josaia125/Proyecto-2-Electronica-2/Evidencia visual/montajefinal.jpeg

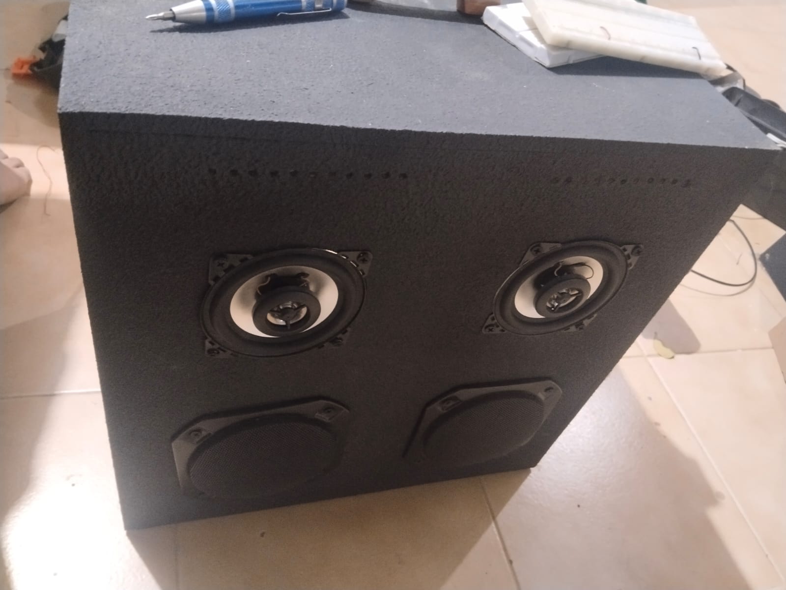
Evidencia visual/montajefinal.jpeg
