josaia125/Proyecto-2-Electronica-2/Evidencia visual/baquela.jpeg

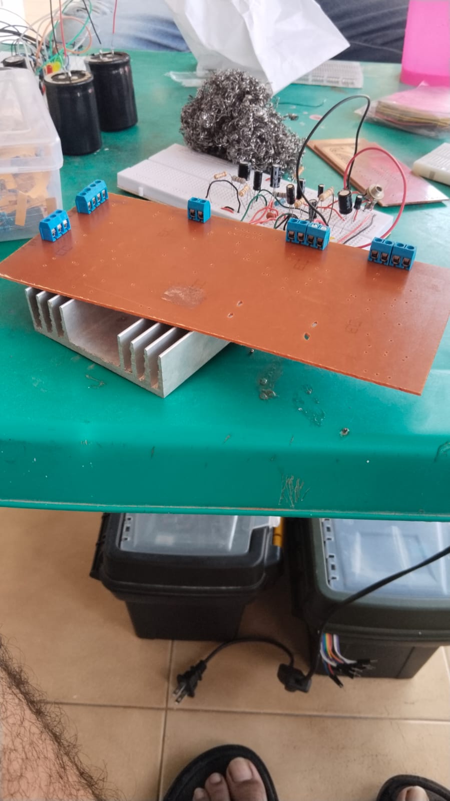
Evidencia visual/baquela.jpeg
