josaia125/Proyecto-2-Electronica-2/Informe-proyecto2.pdf

# Proyecto II: Amplificador Estereo de Alta Fidelidad ´ Basado en TDA2005

Cristian García, Daniel Forero, Juan Lobo, Jesus Bustamante, Jorge De ´ | Avila ´
I. INTRODUCCION´
E

l presente proyecto tiene como finalidad el diseno e im- ˜
plementacion de un amplificador est ´ | ereo de alta fidelidad ´
basado en el circuito integrado TDA2005. Este componente, ampliamente utilizado en aplicaciones de audio automotriz, ofrece una potencia de hasta 20 W y cuenta con protecciones internas que lo convierten en una opcion confiable para el ´ desarrollo de prototipos.
La iniciativa busca integrar distintos elementos de disenõ electronico —como un preamplificador JFET, conectividad ´ Bluetooth, una placa de circuito impreso disenada por el ˜ equipo y una carcasa comercial— con el proposito de obtener ´ un sistema funcional que cumpla con los requisitos tecnicos ´ mínimos y pueda proyectarse hacia aplicaciones reales en el mercado.
Mas all ´ | a de la construcci ´ | on del prototipo, este trabajo repre- ´
senta un ejercicio de aplicacion pr ´ | actica de los conocimientos ´
adquiridos en la formacion acad ´ | emica. Se pretende demostrar ´
como la teor ´ | ía puede transformarse en un producto tangible,
capaz de ofrecer una experiencia sonora de calidad y de responder a las necesidades actuales de consumo tecnologico. ´ Este informe presenta el con texto, los objetivos y los lineamientos de ingeniería que guían el proyecto, así como los entregables esperados y la planificacion necesaria para su ´ desarrollo exitoso.
| | II. OBJETIVOS
A. Objetivo general
Disenar e implementar un amplificador de audio est ˜ | ereo ´
de alta fidelidad basado en el circuito integrado TDA2005, que permita reproducir senales de audio con buena calidad y ˜ cumpla con características funcionales similares a aplicaciones comerciales.
B. Objetivos específicos
- Disenar el circuito del amplificador utilizando el ˜ TDA2005.
- Implementar una etapa de preamplificacion basada en un ´ transistor JFET.
- Integrar un modulo de entrada Bluetooth para la re- ´
cepcion de audio inal ´ | ambrico. ´
- Construir el circuito en una placa PCB garantizando una adecuada distribucion de los componentes. ´
- Implementar una fuente de alimentacion adecuada para ´ el correcto funcionamiento del sistema.
- Evaluar el desempeno del amplificador en t ˜ | erminos de ´
calidad de sonido y funcionamiento.

III. MARCO TEORICO ´

Un amplificador de audio es un dispositivo electronico ´
disenado para incrementar la potencia de una se ˜ | | nal sonora, per- ˜
mitiendo excitar transductores electroacusticos con la energ ´ | ía
necesaria para una reproduccion clara. En sistemas de alta ´
fidelidad (Hi-Fi), la calidad se mide a traves de la Distorsi ´ | on´
Armonica Total (THD) y la Relaci ´ | on Se ´ | nal a Ruido (SNR), ˜
donde valores de SNR superiores a 90 dB garantizan una experiencia libre de ruido perceptible [1].
El nucleo de potencia de este proyecto es el TDA2005, ´ un amplificador Clase B disenado originalmente para audio ˜ automotriz. Este integrado es capaz de entregar hasta 10+10W
en configuracion est ´ | ereo con cargas de ´ | 2Ω, soportando corri-
entes de pico de hasta 3.5A [2]. Una de sus mayores ventajas competitivas es su robustez, ya que incorpora protecciones nativas contra cortocircuitos, sobrecalentamiento y fluctuaciones severas de voltaje (load dump).
Para la etapa de preamplificacion se utilizan transistores de ´
efecto de campo de union (JFET) en configuraci ´ | on de seguidor ´
de fuente (drenaje comun). Esta topolog ´ | ía se caracteriza por
poseer una impedancia de entrada extremadamente alta (Zin ≈ RG) y una impedancia de salida baja, lo que permite acoplar la senal de audio sin cargar la fuente de entrada y minimizando ˜ la distorsion por desajuste de impedancias [3], [4]. ´
En amplificadores de potencia, la gestion del calor es ´ crítica. El diseno de la placa de circuito impreso (PCB) debe ˜ contemplar planos de tierra solidos para reducir EMI y pistas ´ de ancho calculado para soportar la demanda de corriente,
ademas del uso de disipadores t ´ | ermicos para mantener el punto ´
de operacion del silicio dentro de los l ´ | | ímites seguros [7].

IV. RESUMEN
Este documento detalla el diseno, simulaci ˜ | on e imple- ´
mentacion f ´ | ísica de un sistema de amplificacion de audio ´
estereo de alta fidelidad basado en el circuito integrado ´ TDA2005. El proyecto integra una etapa de acondicionamiento
de senal mediante transistores JFET 2N5457 en configuraci ˜ | | on´
de seguidor de fuente, disenada para optimizar la impedancia ˜
de entrada y preservar la integridad de la senal. La metodolog ˜ | ía
incluyo el modelado matem ´ | atico en MATLAB, donde se ´
determino una ganancia te ´ | orica de ´ | 0.88, y la validacion en ´
Proteus, obteniendo una ganancia experimental de 0.96. El sistema incorpora una fuente de alimentacion interna con ´
filtrado robusto de 10, 000µF, conectividad inalambrica v ´ | ía
Bluetooth y una entrada analogica Jack 3.5mm. El prototipo ´ final fue ensamblado en una carcasa comercial utilizando una
PCB de diseno original, cumpliendo con los est ˜ | | andares de ´

robustez, gestion t ´ ermica y calidad sonora exigidos para un ´ producto de nivel comercial.
Palabras clave— Amplificacion de audio, TDA2005, JFET, ´ Impedancia, Bluetooth, PCB, Fidelidad.
V. DESARROLLO

A continuacion, se presenta el desarrollo del proyecto, ´ donde se explica paso a paso la construccion del amplificador ´ de audio, los calculos y analisis hecho. ´

A. Calculos del preamplificador JFET
| | En esta seccion se presentan los c ´ | alculos realizados para el ´
diseno del preamplificador. Para esta etapa hicimos uso de el ˜ JFET 2N5457, se utilizo el siguiente script de MATLAB: ´
1 | %% =============================
2 | % | TRANSCONDUCTANCIA gm
3 | % ==============================
4 | gmo = (2 * IDSS) / abs(VP);
5 | gm | = gmo * (1 - VGSQ/VP);
6 | fprintf(’=== TRANSCONDUCTANCIA ===\n’);
7 | fprintf(’gmo = %.4f mS\n’, gmo*1e3);
8 | fprintf(’gm | = %.4f mS\n\n’, gm*1e3);

9
10 | %% =============================
11 | % | 2) RESISTENCIA RS
12 | % ==============================
13 | % En Drenaje Comun no existe RD -> RD = 0
14 | RS = (VDD - VDS) / IDQ;
15 | fprintf(’=== RESISTENCIAS ===\n’);
16 | fprintf(’RS = %.0f Omega\n\n’, RS);

17
18 | %% =============================
19 | % | CAPACITORES DE ACOPLE (f = 20 Hz)
20 | % ==============================
21 | f | = 20; | % Frecuencia minima [Hz]
22 | Rent = 221e3; | % Resistencia de entrada = Rg
23 | RL | = 70e3; | % Resistencia de carga = Rent
| | TDA2005
24 | C_entrada = 1 / (2*pi*f*Rent);
25 | C_salida | = 1 / (2*pi*f*RL);
26 | fprintf(’=== CAPACITORES DE ACOPLE ===\n’);
27 | fprintf(’C_entrada >= %.2f nF -> C elegido = 2.2 uF\
n’, C_entrada*1e9);
28 | fprintf(’C_salida | >= %.4f uF -> C elegido = 2.2 uF\
n\n’, C_salida*1e6);

29
30 | %% =============================
31 | % | ANALISIS AC
32 | % ==============================
33 | Rg = Rent;
34 | RS_prima = (RS * RL) / (RS + RL); % RS // RL
35 | fprintf(’=== ANALISIS AC ===\n’);
36 | fprintf(’RS’’ = RS // RL = %.2f Omega\n’, RS_prima);

37
38 | % Ganancia de voltaje
39 | Av = (gm * RS_prima) / (1 + gm * RS_prima);
40 | fprintf(’Av | = %.4f\n’, Av);

41
42 | % Impedancias
43 | Zin | = Rg;
44 | Zout = RS_prima;
45 | fprintf(’Zin | = %.2f MOhm\n’, Zin/1e6);
46 | fprintf(’Zout = %.2f Omega\n\n’, Zout);

47
48 | %% =============================
49 | % | GANANCIA DE CORRIENTE
50 | % ==============================
51 | Ai = Av * (Rg / RL);
52 | fprintf(’=== GANANCIA DE CORRIENTE ===\n’);
53 | fprintf(’Ai = %.4f\n\n’, Ai);

Listing 1. Script de diseno en MATLAB ˜

Los resultados obtenidos en la consola tras la ejecucion son ´ los siguientes:

=== PUNTO Q ===
IDQ = 1.50 mA
VGSQ = -0.90 V
VDS = 9.00 V

=== TRANSCONDUCTANCIA ===
gmo = 2.0000 mS
gm = 1.4000 mS

=== RESISTENCIAS ===
RS = 6000 Omega

=== CAPACITORES DE ACOPLE ===
C_entrada >= 36.01 nF | -> C elegido = 2.2 uF
C_salida | >= 0.1137 uF -> C elegido = 2.2 uF

=== ANALISIS AC ===
RS’ = RS // RL = 5526.32 Omega
Av | = 0.8855
Zin | = 0.22 MOhm
Zout = 5526.32 Omega

=== GANANCIA DE CORRIENTE === Ai = 2.7958

========== RESUMEN ==========
IDQ | = 1.50 | mA
VGSQ | = -0.90 | V
VDS | = 9.00 | V
gm | = 1.4000 mS
RS | = 6000 | Omega
Av | = 0.8855
Ai | = 2.7958
Zin | = 0.2 | MOhm
Zout | = 5526.32 | Omega
C_ent = 2.2 uF
C_sal = 2.2 uF
==============================

Listing 2. Salida de consola de MATLAB actualizada

B. Acondicionamiento (Preamplificador JFET)

Siguiendo la arquitectura del sistema, la etapa de acondicionamiento se basa en un preamplificador con transistores JFET J111 en configuracion de seguidor de fuente. Esta etapa ´
es crucial para procesar la senal proveniente del m ˜ | odulo ´
Bluetooth antes de su ingreso a la etapa de potencia. Para
validar el diseno, se realiz ˜ | o una simulaci ´ | on en Proteus con ´
una senal de entrada de ˜ | 100mV a 5kHz.
1) Analisis de Corrientes y Punto Q: ´ | | Como se observa
en la simulacion de la Figura 1, el dispositivo presenta un ´ comportamiento ideal para el acoplamiento de senales. La ˜ corriente de compuerta (Ig) es de 0mA debido al aislamiento
electrico del FET, mientras que las corrientes de drenaje ( ´ | Id)
y fuente (Is) se mantienen equilibradas en 1.74mA.

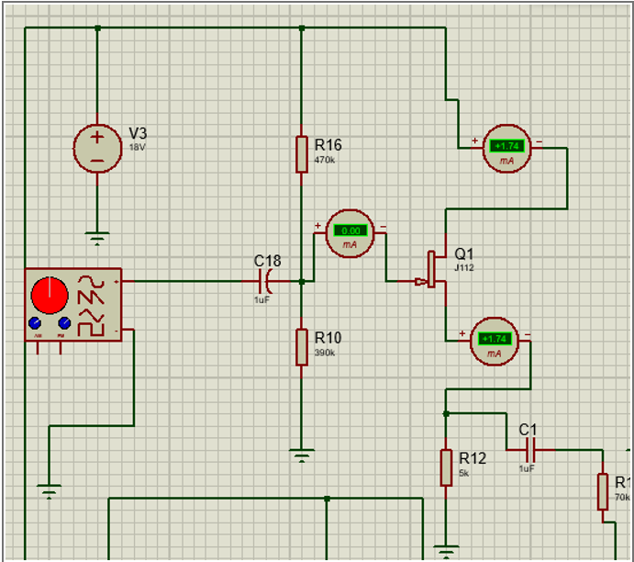
[picture p3: figure]

Fig. 1. Simulacion de corrientes en el preamplificador (Id = Is = 1.74 ´ | mA).
2) Analisis de Voltajes en DC: ´ | En la Figura 2 se detallan
los niveles de tension obtenidos. Los resultados confirman que ´ el transistor opera en su region activa, permitiendo el flujo de ´
senal sin distorsi ˜ | on hacia el TDA2005. ´

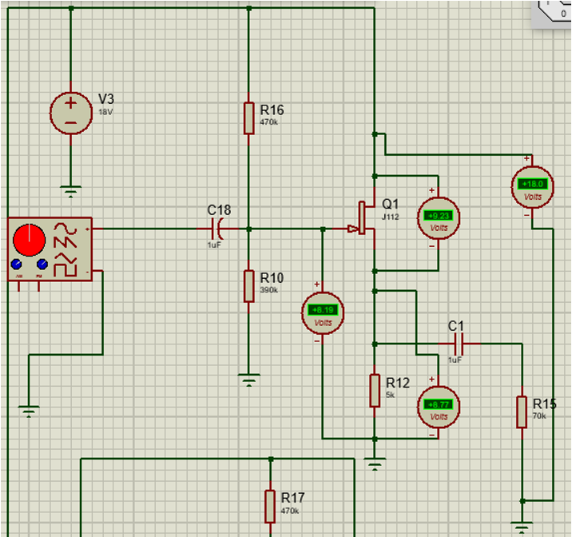
[picture p4: figure]

Fig. 2. Distribucion de voltajes en los nodos del JFET 2N5457. ´

3) Validacion de la Ganancia de Voltaje ( ´ | Av): Para ver-
ificar la eficiencia de la etapa de acondicionamiento, se
midieron las senales de entrada ( ˜ | Vi) y salida (Vo) mediante
un osciloscopio digital en el entorno de simulacion. Los ´ parametros configurados en los generadores fueron una am- ´ plitud de 100mV a una frecuencia de 5kHz.

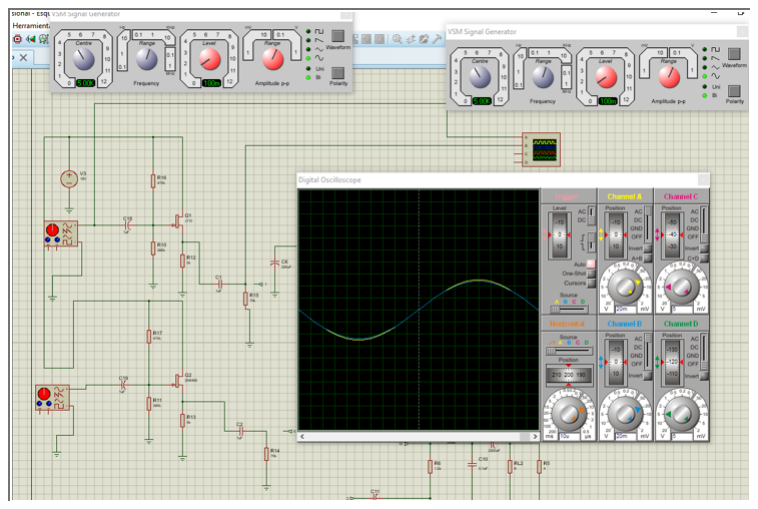
[picture p5: figure]

Fig. 3. Medicion de se ´ | nales de entrada y salida en el osciloscopio digital. ˜

Basado en las capturas del osciloscopio, el analisis de las ´ divisiones por voltajes es el siguiente:
- Voltaje de Entrada (Vi): 5 divisiones × 20 mV/div = 0.1V .
- Voltaje de Salida (Vo): 4.8 divisiones × 20 mV/div = 0.096V .
A partir de estos datos, se calculo la ganancia de voltaje ´ experimental (Av exp):

Av =

Vo
Vi

=

0.096
0.1
| | | = 0.96 | | (1)
Analisis de resultados: ´ | La ganancia obtenida experimen-
talmente (0.96) presenta una alta correlacion con el valor ´
teorico calculado en MATLAB ( ´ | 0.8855), validando que el
preamplificador JFET en configuracion de seguidor de fuente ´ cumple satisfactoriamente con su funcion de acoplamiento ´
sin perdidas significativas de se ´ | | nal. Los valores de tensi ˜ | | | on´
registrados respecto a tierra son:
- Voltaje de Compuerta (Vg): 8.19V .
- Voltaje de Drenaje (Vd): 18V .
- Voltaje de Fuente (Vs): 8.77V .
- Tension Drenaje-Fuente ( ´ | Vds): 9.23V .
4) Observaciones del Comportamiento: Se determino que, ´ mientras las corrientes de drenaje y fuente mantienen la misma magnitud, los voltajes en dichos terminales difieren significativamente (18V frente a 8.77V ). Esta caída de tension´ es necesaria para establecer el punto de polarizacion requerido, ´ garantizando que la senal de audio se mantenga dentro de los ˜ margenes de linealidad del componente. ´
C. Esquema | del | Preamplificador | (Etapa | de | Acondi-
cionamiento)

El esquema del preamplificador, detallado en la Figura 4,
constituye la implementacion f ´ | ísica de la etapa de acondi-
cionamiento estereo. El dise ´ | no se basa en dos transistores ˜
de efecto de campo (U1 y U2) en configuracion de seguidor ´
de fuente, permitiendo una adaptacion de impedancias ´ | optima ´
entre la entrada inalambrica y la etapa de potencia. ´

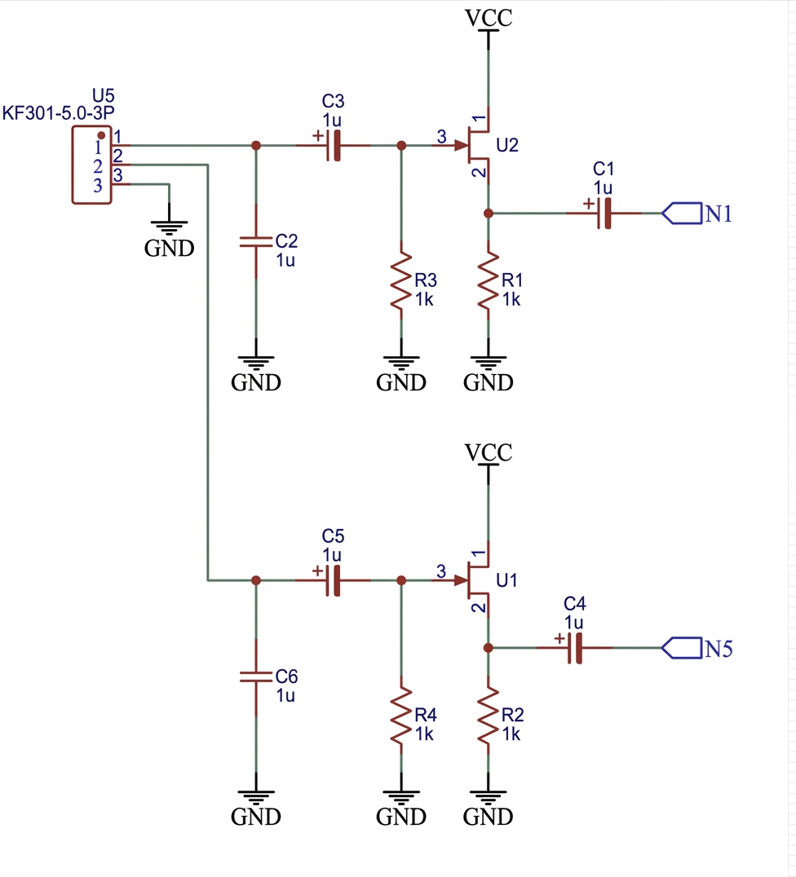
[picture p6: figure]

Fig. 4. Diagrama esquematico de la etapa de preamplificaci ´ | on est ´ | ereo. ´
1) Descripcion de Componentes y Funcionalidad: ´ | El cir-
cuito utiliza una arquitectura simetrica para procesar am- ´ bos canales de audio, empleando los siguientes componentes críticos:
- Terminal de Entrada (U5): El conector KF301 permite
la recepcion de las se ´ | nales izquierda y derecha junto con ˜
la referencia de tierra comun del sistema. ´
- Acoplamiento de Entrada (C3, C5): Capacitores de 1µF encargados de bloquear la componente de corriente continua (DC), permitiendo unicamente el paso de la ´ senal de audio variable. ˜
- Filtros de Desacoplo (C2, C6): Condensadores dispuestos en paralelo a la entrada para estabilizar la senal ˜ y filtrar posibles ruidos de alta frecuencia.
- Polarizacion de Compuerta ( ´ | R3, R4): Resistencias de
1kΩ que referencian la compuerta a tierra, definiendo la impedancia de entrada y el punto de trabajo de los transistores.
- Resistencias de Fuente (R1, R2): Componentes de 1kΩ que determinan la corriente de drenaje en reposo y establecen la baja impedancia de salida necesaria para excitar el TDA2005.
- Acoplamiento de Salida (C1, C4): Capacitores de 1µF que entregan la senal acondicionada a los nodos de salida ˜ (N1, N5) para su posterior amplificacion de potencia. ´
Esta configuracion garantiza que la se ´ | nal de audio conserve ˜
su integridad lineal, proporcionando la ganancia de corriente necesaria para manejar la etapa de potencia sin degradar la calidad sonora.
D. Etapa de Potencia

La etapa de potencia constituye el nucleo del sistema de ´
amplificacion, encargada de entregar la energ ´ | ía necesaria a
los altavoces con la fidelidad requerida. Para este proyecto, se
implemento el circuito integrado ´ | TDA2005, un amplificador
de potencia de audio de clase B disenado espec ˜ | íficamente para
aplicaciones estereo en entornos automotrices y dispositivos ´ portatiles. ´

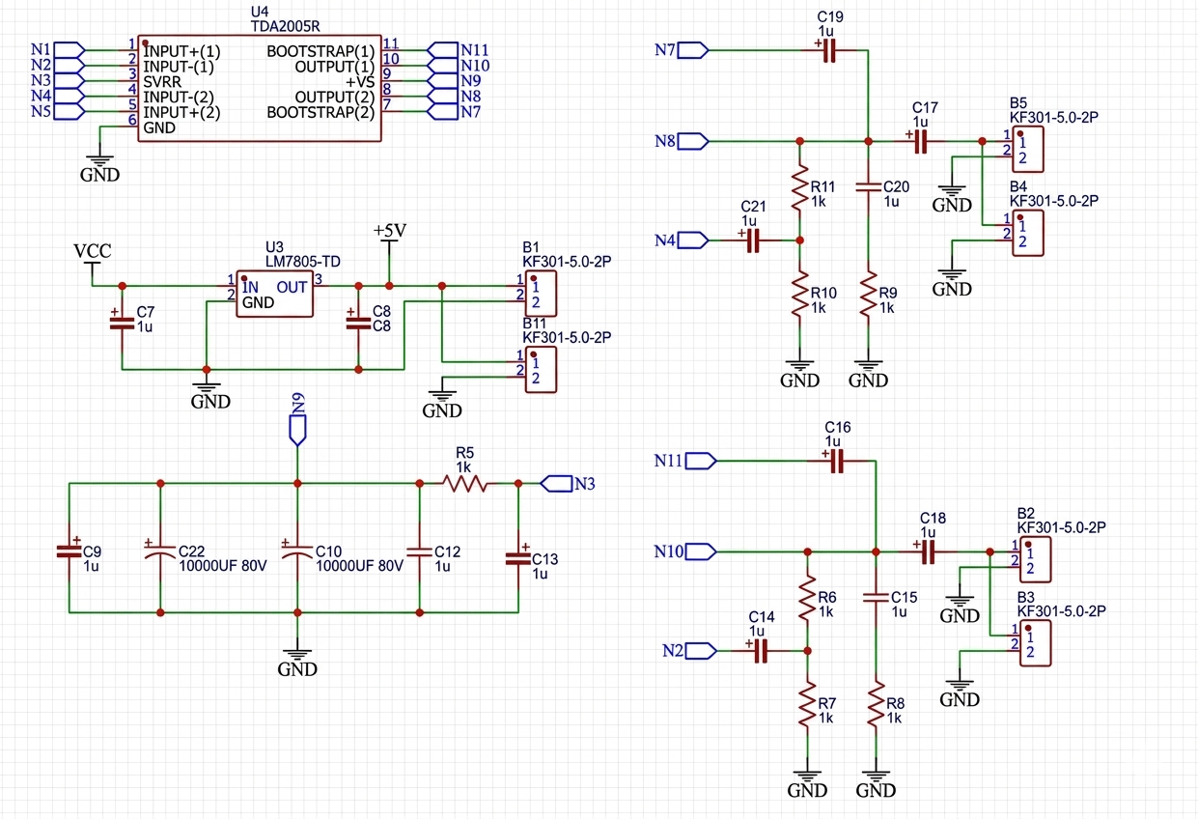
[picture p7: figure]

Fig. 5. Diagrama esquematico de la etapa de potencia y perif ´ | ericos basado ´
en el TDA2005
1) Descripcion del Dise ´ | no y Componentes: ˜ | El esquema
tecnico de la Figura 5 presenta una implementaci ´ | on est ´ | ereo ´
que integra tanto el bloque de amplificacion como los sis- ´ temas de soporte y proteccion. Los elementos principales se ´ describen a continuacion: ´
- Circuito Integrado TDA2005 (U4): El componente central gestiona las entradas de senal ( ˜ N1 a N5) y proporciona las salidas de potencia (N7 a N11) protegidas contra sobrecargas termicas y cortocircuitos. ´
- Red de Estabilizacion de Salida (Filtro Zobel): ´ | Se ob-
serva la integracion de redes compuestas por resistencias ´ (como R9, R10) y capacitores (C20, C15). Estas redes son fundamentales para garantizar la estabilidad del amplificador, evitando oscilaciones parasitas de alta frecuencia ´ cuando se conectan cargas inductivas (altavoces).
- Filtrado de Fuente de Alimentacion: ´ El diseno incluye ˜ una etapa de filtrado robusta con capacitores electrolíticos de gran capacidad (C22, C10) de 10, 000µF. Estos actuan ´ como reservorios de energía para manejar los picos de corriente durante la reproduccion de bajas frecuencias y ´ minimizan el rizado de la fuente.
- Regulacion Auxiliar (U3): ´ | Se integra un regulador de
voltaje LM7805 para proporcionar una salida estable de
+5V , destinada a alimentar perifericos como el m ´ | odulo ´
de entrada Bluetooth, asegurando que el ruido de la etapa de potencia no afecte a la electronica de control. ´
- Acoplamiento y Proteccion: ´ Los capacitores de acoplamiento distribuidos en el circuito (como C19, C16) aseguran que la senal de audio se transfiera eficientemente ˜

entre etapas mientras se bloquea cualquier componente de corriente continua que pudiera danar los transductores. ˜

2) Consideraciones de Implementacion: ´ Aunque el sistema no requiere calculos de ganancia externos debido a la ar- ´
quitectura interna del TDA2005, la disposicion f ´ | ísica de los
componentes y el uso de terminales de conexion KF301 ( ´ | B1
a B5) se seleccionaron para facilitar el montaje en la placa PCB y garantizar conexiones de baja resistencia, minimizando las perdidas de potencia y el calentamiento excesivo durante ´ el funcionamiento a maximo volumen. ´

VI. IMPLEMENTACION´ FÍSICA Y MONTAJE

En esta seccion se detalla la transici ´ | on del dise ´ | no te ˜ | orico ´
hacia el prototipo físico, integrando la manufactura de la PCB, la gestion de potencia interna y el ensamblaje final en el chasis. ´
A. Sistema de Alimentacion Interna ´

Para cumplir con el requisito de autonomía del sistema,
se adquirio una fuente de alimentaci ´ | on interna dedicada 6. ´
Esta decision t ´ | ecnica elimina la dependencia de adaptadores ´
externos y garantiza una entrega de corriente constante para los picos de potencia del TDA2005.

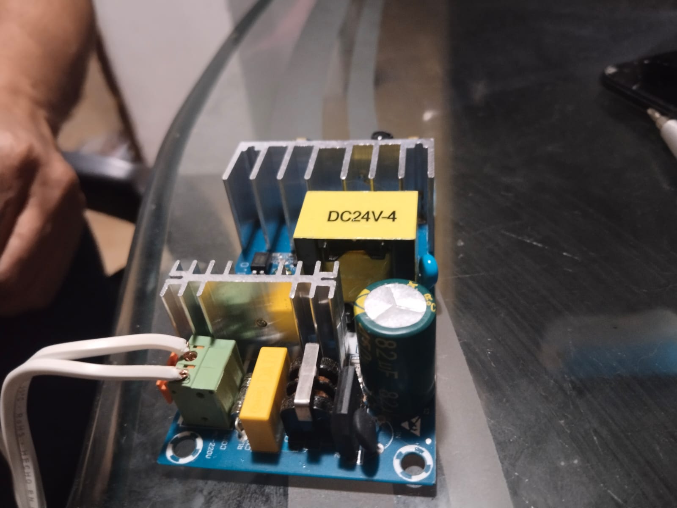
[picture p8: figure]

Fig. 6. Fuente de voltaje conmutada 24V 4-6A

B. Interfaz de Entrada Dual (Bluetooth y Jack 3.5mm)
El diseno inicialmente permit ˜ | ía como versatilidad una in-
terfaz por modulo bluetooth, pero al observar problemas de
ruido, se establecio dos formas de entrada de se ´ | nal: ˜
- Modulo Bluetooth: ´ | Integrado internamente y acoplado a
la etapa JFET. Permite la reproduccion inal ´ | ambrica con ´
un alcance de hasta 10 metros.
- Entrada Auxiliar: Un conector Jack de 3.5mm permite
la conexion de fuentes anal ´ | ogicas. ´
C. Diseno y Manufactura de la PCB ˜
Siguiendo los criterios de diseno original, se desarroll ˜ | o un ´
layout optimizado para audio de potencia.

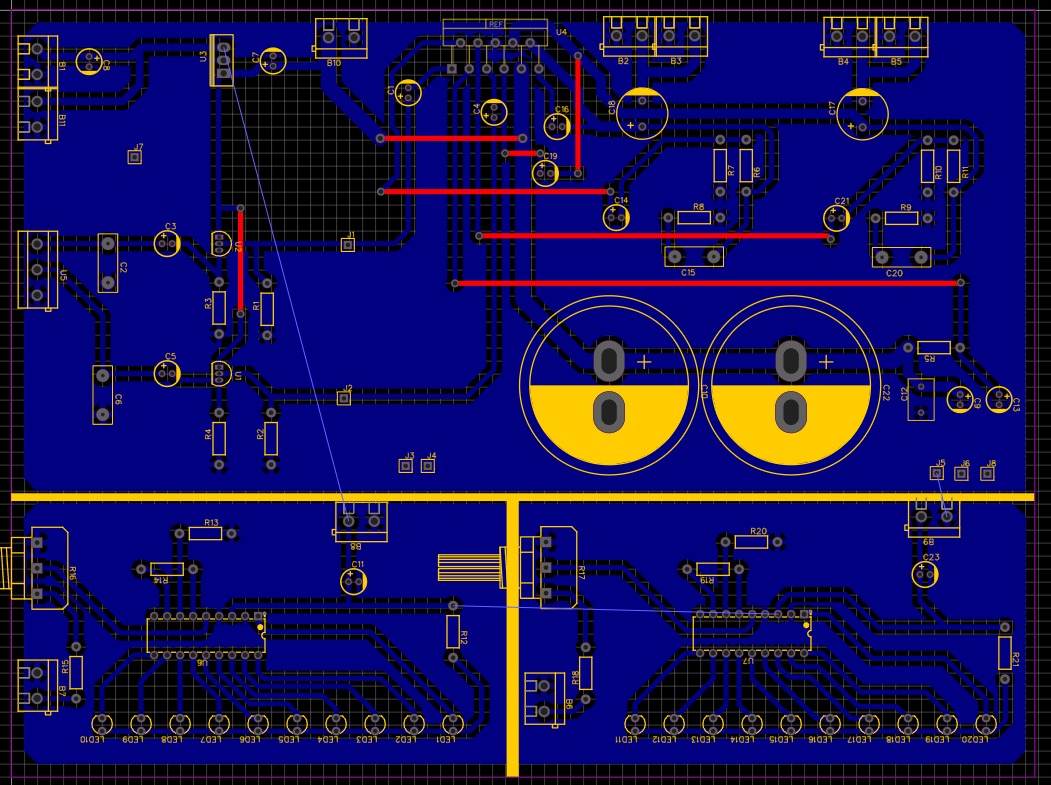
[picture p9: figure]

Fig. 7. Layout original de la PCB

Estrategias de diseno aplicadas: ˜
Rutas de Alta Corriente: Las pistas que conectan la fuente con el TDA2005 y las salidas de los altavoces se disenaron ˜ con un ancho superior (mínimo 50 mils) para minimizar la resistencia ohmica. ´
Integridad de Senal: ˜ Los componentes del preamplificador JFET se agruparon en una zona aislada de las líneas de AC
para reducir la induccion electromagn ´ | etica. ´
D. Prototipado en Protoboard y Pruebas Iniciales
Antes de proceder con el diseno permanente, se realiz ˜ | o un ´
montaje en protoboard para validar la interaccion entre las ´ etapas de acondicionamiento y potencia.
- Validacion de Etapas: ´ | Se comprobo que el preamplifi- ´
cador JFET no introdujera ruido termico excesivo al ser ´ conectado a la entrada del TDA2005.
- Gestion de la Fuente Interna: ´ | Se probo el circuito de ´
rectificacion y filtrado (puente de diodos y capacitores ´ de 10, 000µF) para asegurar que el voltaje DC fuera estable bajo carga y que el regulador LM7805 entregara
los 5V necesarios para el modulo Bluetooth sin ca ´ | ídas
de tension. ´
- Ajustes de Ganancia: Se verifico auditivamente que la ´ ganancia de la etapa de acondicionamiento fuera suficiente para excitar el amplificador de potencia utilizando
tanto el modulo inal ´ | ambrico como la entrada Jack 3.5mm. ´

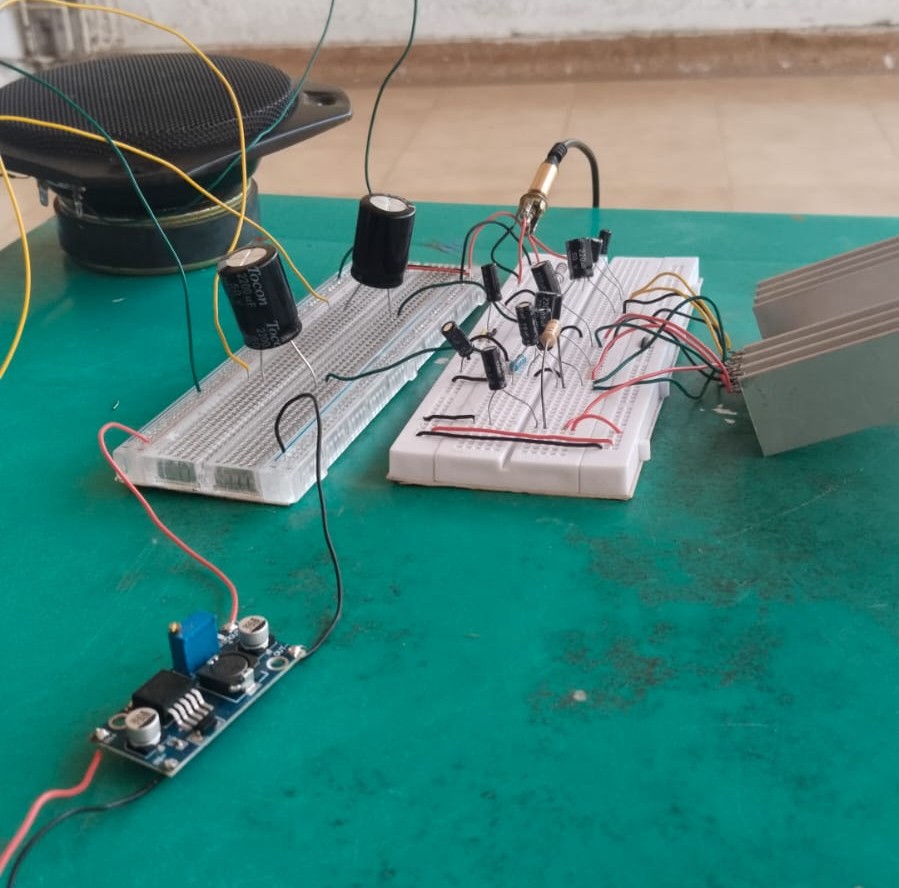
[picture p10: figure]

Fig. 8. Circuito total en Protoboard

E. Montaje en PCB
Siguiendo los requisitos de ingeniería, se ensamblo en la ´ placa de circuito impreso (PCB) para minimizar el ruido y optimizar el espacio interno de la carcasa.

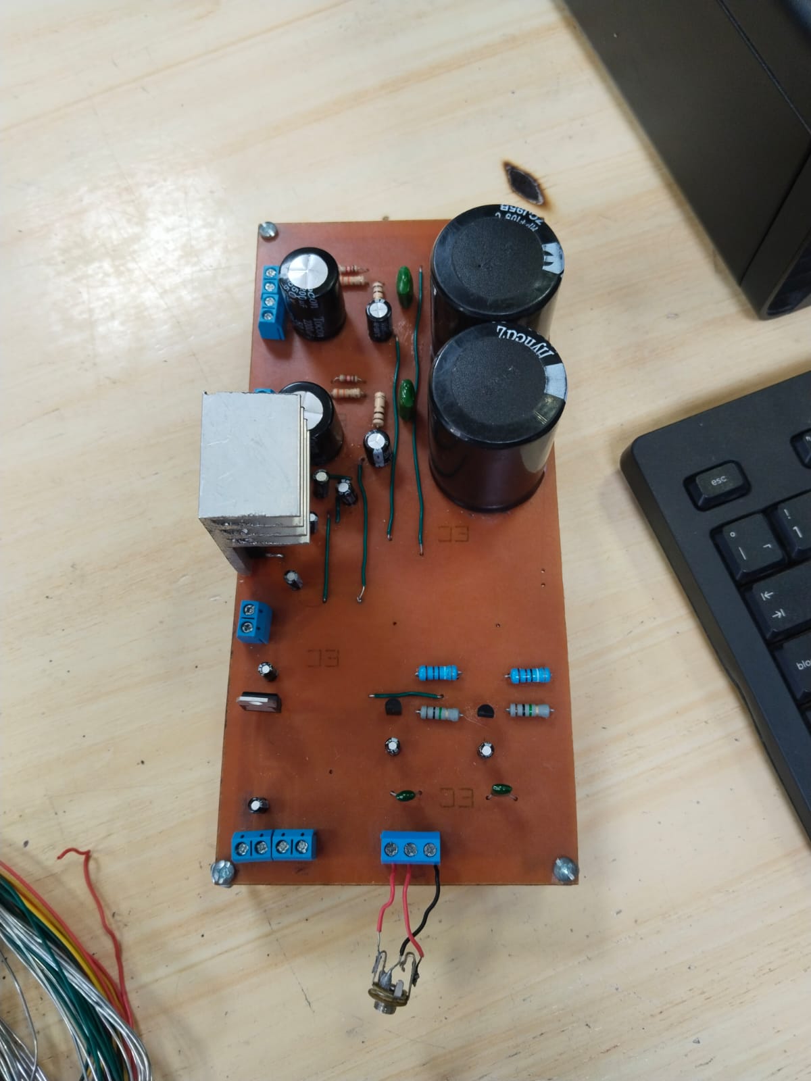
[picture p11: figure]

Fig. 9. Montaje en placa PCB

Detalles del ensamblaje:
- Gestion T ´ | ermica: ´ | El TDA2005 fue montado sobre un
disipador de aluminio acoplado mecanicamente al chasis ´ para maximizar el area de transferencia de calor. ´
- Acabado de Usuario: Se instalaron potenciometros ro- ´ tativos para el control de volumen y bornes KF301 para
una conexion segura de los altavoces, logrando la est ´ | etica ´
de un producto comercial final.
F. Armado Final en Caja Comercial
La etapa final consistio en el mecanizado e integraci ´ | on´
de todos los modulos dentro de un chasis comercial de ´ dimensiones: Alto: 42cm, Ancho: 28cm, Frente: 42cm y así ofrecer un producto terminado y funcional.


Fig. 10. Vista del amplificador ensamblado y listo para el usuario final.

G. Roles y Responsabilidades
Para la ejecucion exitosa del proyecto, se definieron roles es- ´
pecíficos segun las fortalezas t ´ | | ecnicas de cada integrante, ase- ´
gurando una distribucion equitativa del trabajo y el cumplim- ´ iento de los hitos tecnicos: ´
- Cristian García: Responsable de la gestion de la doc- ´
umentacion t ´ | ecnica, apoyo en la redacci ´ | on del informe ´
final y supervisor del cumplimiento de normas IEEE.
- Daniel Forero: Encargado de los calculos matem ´ | aticos ´
y fundamentacion te ´ | orica, dise ´ | no de la etapa de potencia ˜
y supervision de la implementaci ´ | on f ´ | ísica.
- Juan Lobo: Responsable del diseno y mecanizado de la ˜ carcasa comercial, ademas del ensamblaje y soldaje de ´ componentes electronicos. ´
- Jesus Bustamante: ´ | | Especialista en simulacion, encar- ´
gado de validar el comportamiento del sistema en Proteus y verificar los puntos de operacion (Punto Q). ´
- Jorge De Avila: ´ | Co-responsable de la documentacion´
tecnica y c ´ | alculos matem ´ | aticos en MATLAB y l ´ | íder en
la creacion de la presentaci ´ | on final para la sustentaci ´ | on´
academica. ´
| | VII. CONCLUSIONES
- Se disenõ e implement ´ | o con ´ | exito un sistema de amplifi- ´
cacion est ´ | ereo de alta fidelidad, integrando una etapa de ´
acondicionamiento JFET y una etapa de potencia con el TDA2005. El prototipo final demostro estabilidad opera- ´ tiva y una calidad sonora alineada con las expectativas de un sistema de audio comercial, cumpliendo así el objetivo general del proyecto.
- La etapa de preamplificacion mediante transistores JFET ´
J112 resulto fundamental para la adaptaci ´ | on de impedan- ´
cias. La validacion experimental arroj ´ | o una ganancia de ´
voltaje de 0.96, valor que guarda una estrecha correlacion´

con el diseno te ˜ | orico y asegura que la se ´ | nal proveniente ˜
del modulo Bluetooth o la entrada Jack sea procesada sin ´
degradacion ni p ´ | erdida de fidelidad. ´
- La implementacion de una fuente de alimentaci ´ | on in- ´
terna dedicada con filtrado de 10, 000µF garantizo la ´ autonomía del sistema y la estabilidad frente a picos
de corriente. Esta solucion t ´ | ecnica permiti ´ | o minimizar ´
el ruido de rizado de la red electrica, asegurando una ´
relacion se ´ | nal-ruido ˜ | optima para aplicaciones de alta ´
fidelidad.
- El diseno y fabricaci ˜ | on de la placa de circuito im- ´
preso (PCB) original permitio una distribuci ´ | on es- ´
trategica de componentes, reduciendo interferencias elec- ´ tromagneticas y facilitando el manejo de corrientes de ´ hasta 3.5A. El montaje final en un chasis comercial mecanizado transformo el circuito en un producto fun- ´ cional y ergonomico para el usuario final. ´
- La integracion del m ´ | odulo de conectividad Bluetooth ´
demostro la viabilidad de modernizar arquitecturas de ´
audio analogicas cl ´ | asicas. El uso del regulador LM7805 ´
para alimentar esta etapa periferica fue una decisi ´ | on´
de diseno acertada que evit ˜ | o interferencias en la etapa ´
de potencia, logrando una interfaz de usuario versatil y ´ actual.
- Finalmente, el uso sistematico de herramientas de sim- ´
ulacion (Proteus) y c ´ | | | | alculo num ´ | | erico (MATLAB) fue ´
determinante para el exito del proyecto. La capacidad de ´ predecir el comportamiento del punto Q y las impedancias del sistema permitio reducir significativamente el ´ margen de error durante la fase de implementacion f ´ ísica y soldadura.

REFERENCES

[1] Moon Audio, “Hi-Fi Amplifiers Explained: How to Get the Best Sound Quality,” [En línea]. Disponible en: https://www.moon-audio.com/hifiamplifiers-explained-best-sound-quality/
[2] STMicroelectronics, “TDA2005: 20 W Bridge/Stereo Amplifier for Car Radio,” Datasheet Rev. 6, septiembre 2013. [En línea]. Disponible en: https://www.st.com/resource/en/datasheet/tda2005.pdf
[3] Nuts | & | Volts | Magazine, | “FET | Principles | and | Cir-
cuits | — | Part | 2,” | 2013. | [En | línea]. | Disponible | en:
https://www.nutsvolts.com/magazine/article/fet principles and circuits part 2
[4] J. M. Fiore, “Common Drain Amplifier,” en Semiconductor Devices – Theory and Application, Engineering LibreTexts, cap. 11. [En línea]. Disponible en: https://eng.libretexts.org
[5] IEEE Spectrum, “Is Bluetooth LE Audio the Future of Wireless Audio?” IEEE Spectrum, febrero 2026. [En línea]. Disponible en: https://spectrum.ieee.org/bluetooth-low-energy-audio
[6] Wikipedia, “List of Bluetooth Profiles – A2DP,” Wikipedia:
The | Free | Encyclopedia, | 2026. | [En | línea]. | Disponible | en:
https://en.wikipedia.org/wiki/List of Bluetooth profiles
[7] AllPCB, “Thermal Management in Audio Amplifier PCBs: Strategies for High-Power Designs,” AllPCB Blog, agosto 2025. [En línea]. Disponible en: https://www.allpcb.com/blog/pcb-knowledge/thermal-managementin-audio-amplifier-pcbs.html
