josaia125/Proyecto-2-Electronica-2/Evidencia visual/caja.jpeg

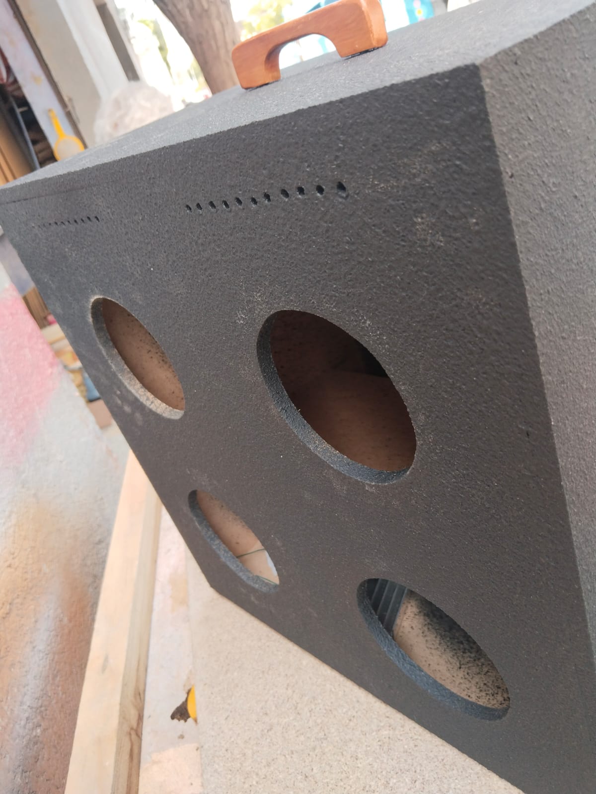
Evidencia visual/caja.jpeg
