josaia125/Proyecto-2-Electronica-2/Evidencia visual/diseño.jpeg

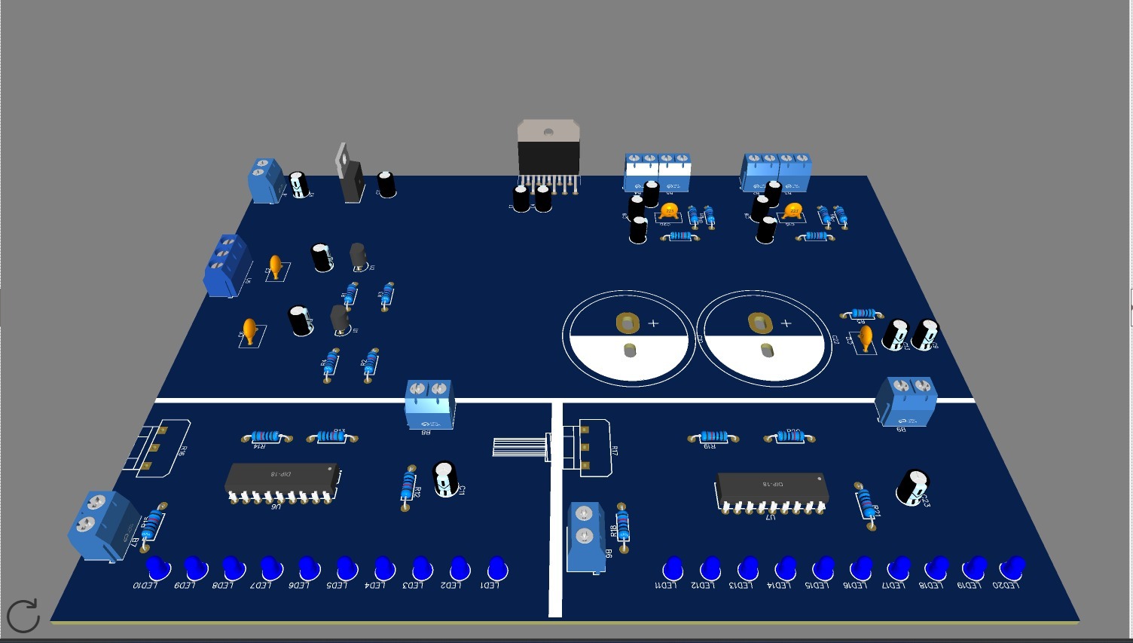
Evidencia visual/diseño.jpeg
