josaia125/Proyecto-2-Electronica-2/Evidencia visual/fuente-regulador.jpeg

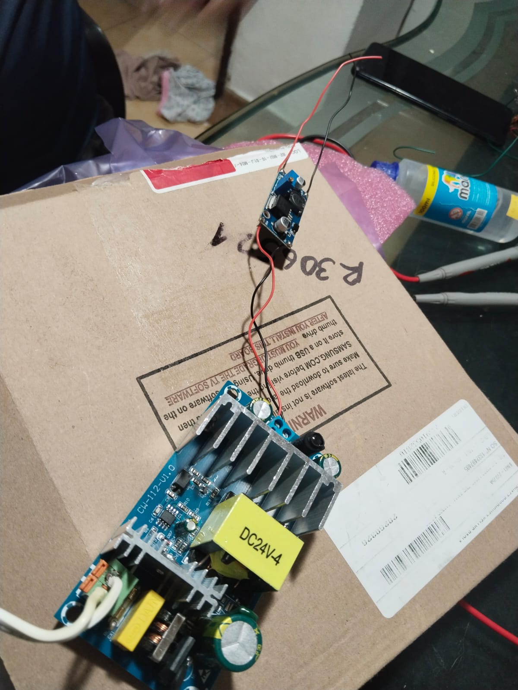
Evidencia visual/fuente-regulador.jpeg
