josaia125/Proyecto-2-Electronica-2/Evidencia visual/modulo.jpeg

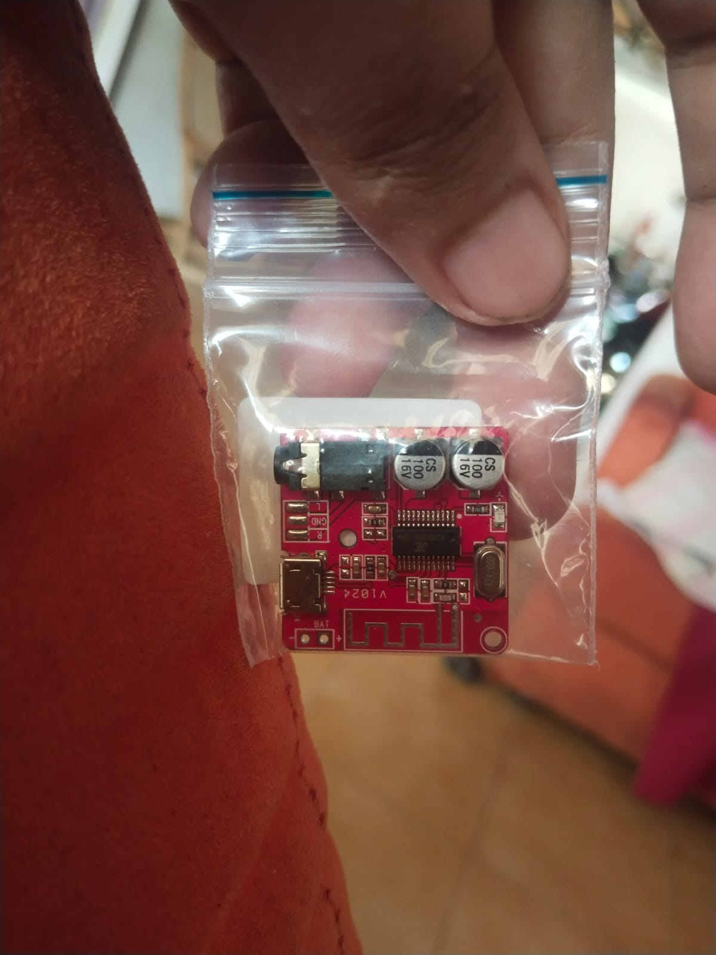
Evidencia visual/modulo.jpeg
