josaia125/Proyecto-2-Electronica-2/Evidencia visual/parlantes.jpeg

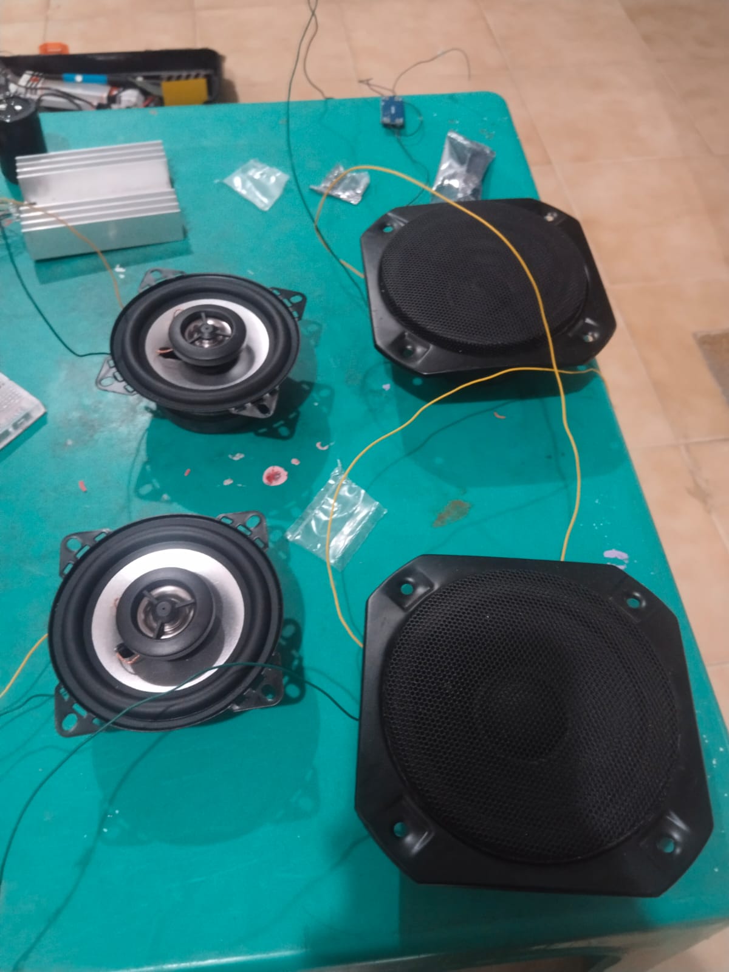
Evidencia visual/parlantes.jpeg
