josaia125/Proyecto-2-Electronica-2/Evidencia visual/proto.jpeg

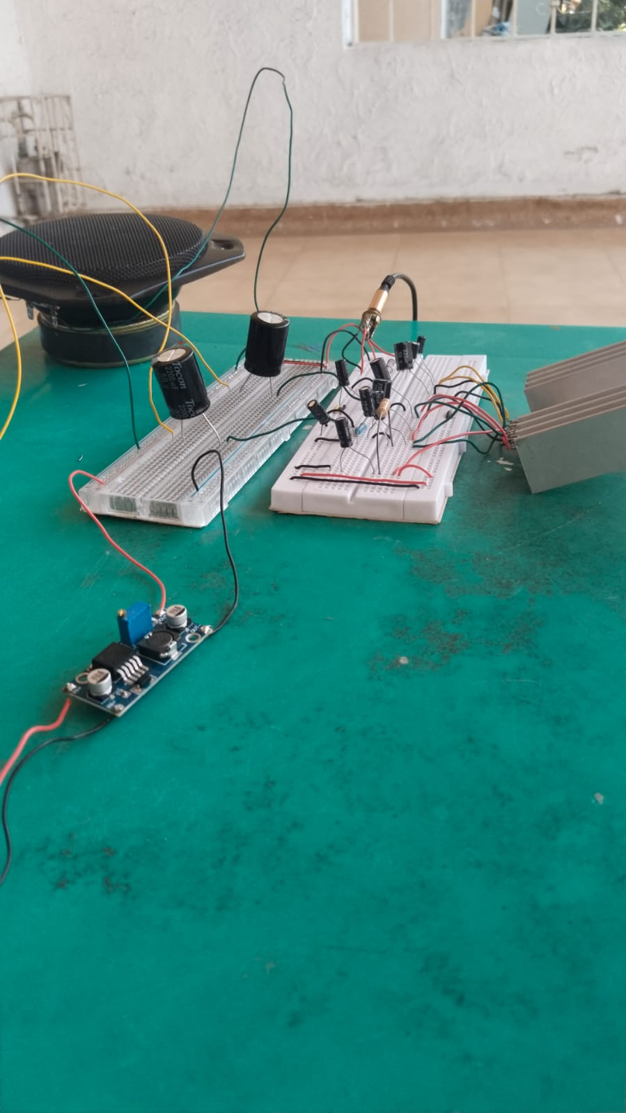
Evidencia visual/proto.jpeg
