josaia125/Proyecto-2-Electronica-2/Evidencia visual/vum.jpeg

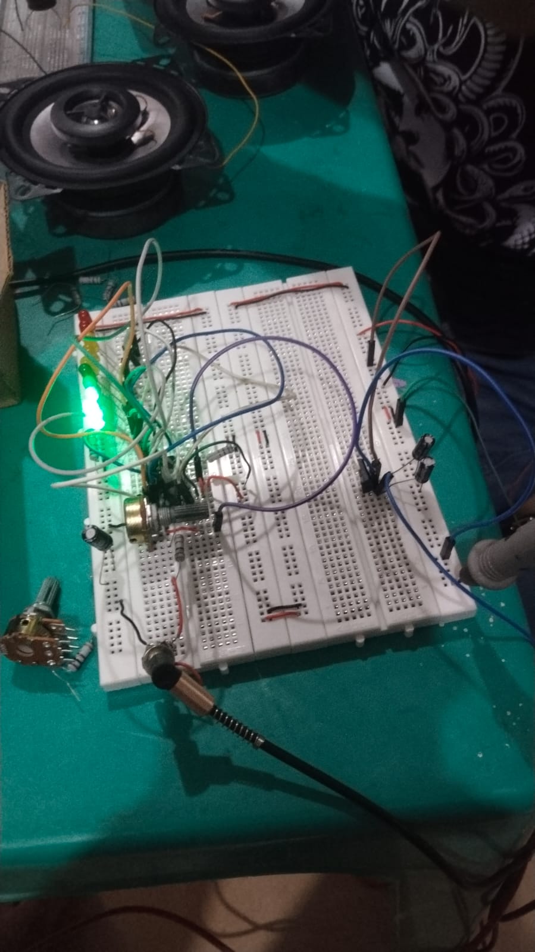
Evidencia visual/vum.jpeg
