josaia125/Proyecto-2-Electronica-2/Originalidad/esquema.jpeg

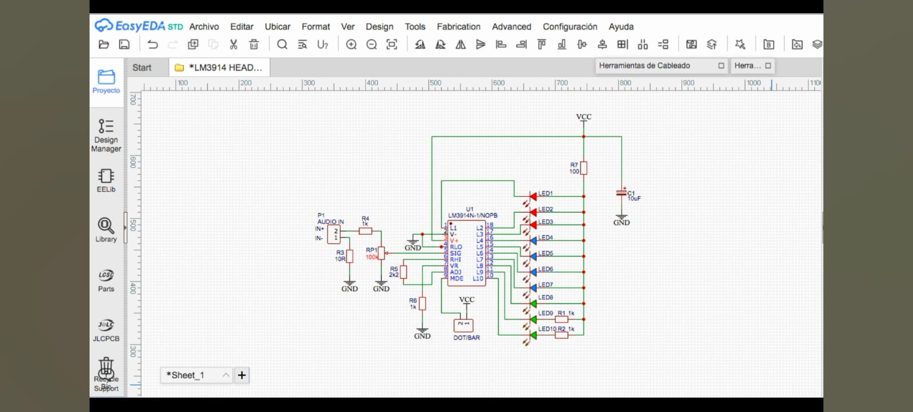
Originalidad/esquema.jpeg
