josaia125/Proyecto-2-Electronica-2/(list of files, drawings)

Other design files:
Simulación preamplificador/Stereo.pdsprj
